Daleth7/QIF-model/Images/2015-12-08 13.44.57.jpg

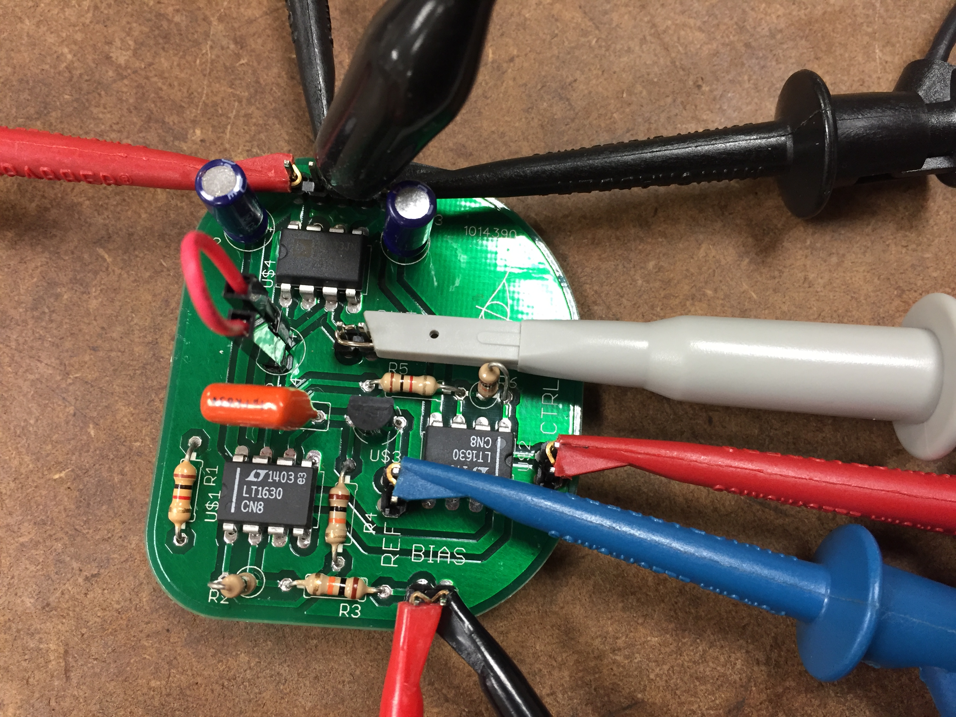
Images/2015-12-08 13.44.57.jpg
