Daleth7/QIF-model/Images/2015-12-08 13.44.27.jpg

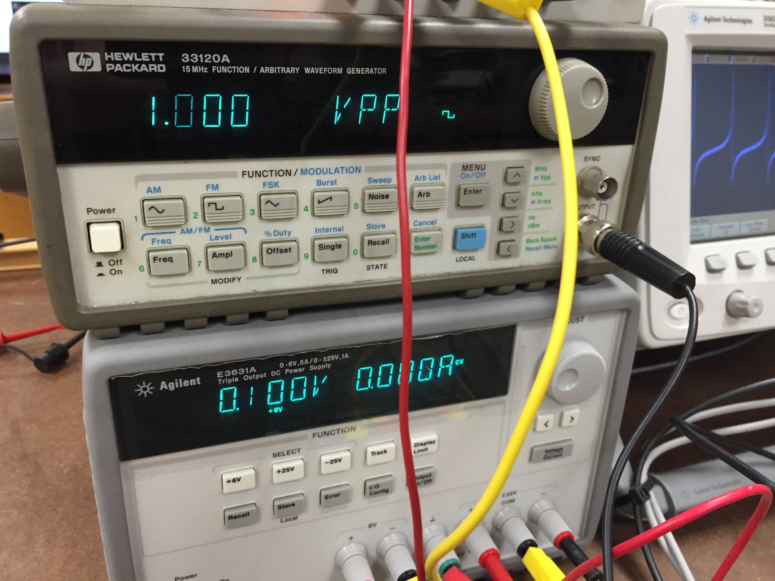
Images/2015-12-08 13.44.27.jpg
