Daleth7/QIF-model/Images/2015-12-08 13.45.04.jpg

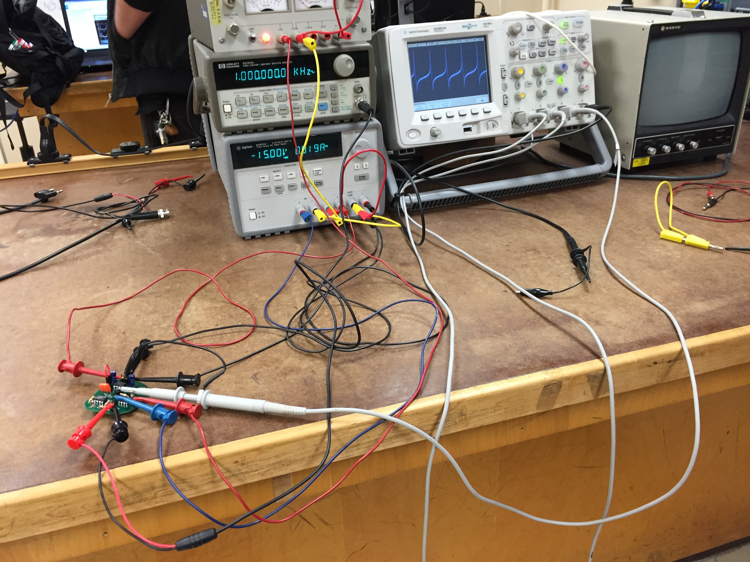
Images/2015-12-08 13.45.04.jpg
