Daleth7/QIF-model/Images/2015-12-08 13.54.20.jpg

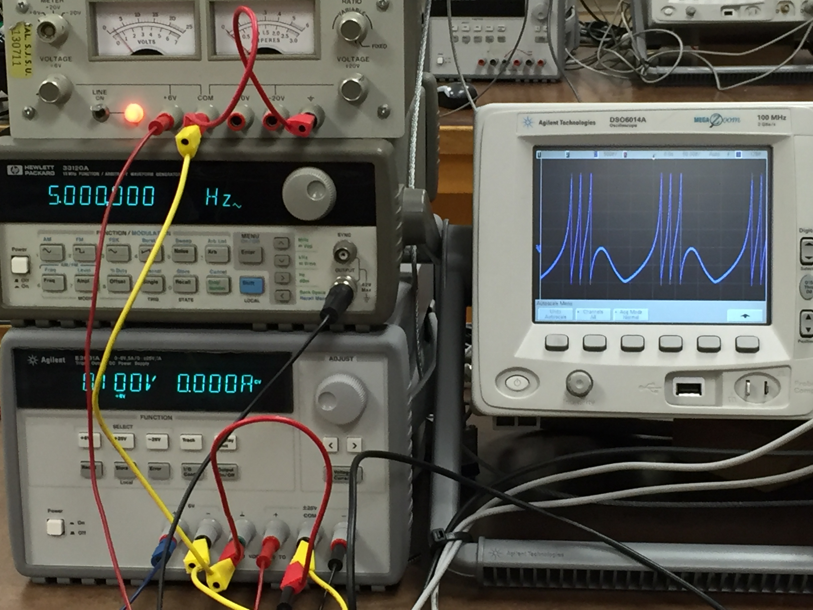
Images/2015-12-08 13.54.20.jpg
