Daleth7/QIF-model/QIF_Final.asc

C1: cap; 10µ
C2: cap; 1µ
M1: nmos; 2N7002
R2: res; 10k
R3: res; 1k
R4: res; 10k
R5: res; 10k
R6: res; 10k
R7: res; 1k
U1: LT1630
U2: LT1630
U4: LT1630
V1: voltage; 15
V2: voltage; -15
V3: voltage; PULSE(-1 1 0.1 0.5 0.5 0 1.2)
V4: voltage; 0.1
V5: voltage; 0.5
X1: ad633
Named nets: 0, +, -, Bias, OUT, V_sq, ref, ctrl
.tran 1.5 startup
