Daleth7/QIF-model/QIF.brd

## EAGLE design QIF.brd (2016-01-04)

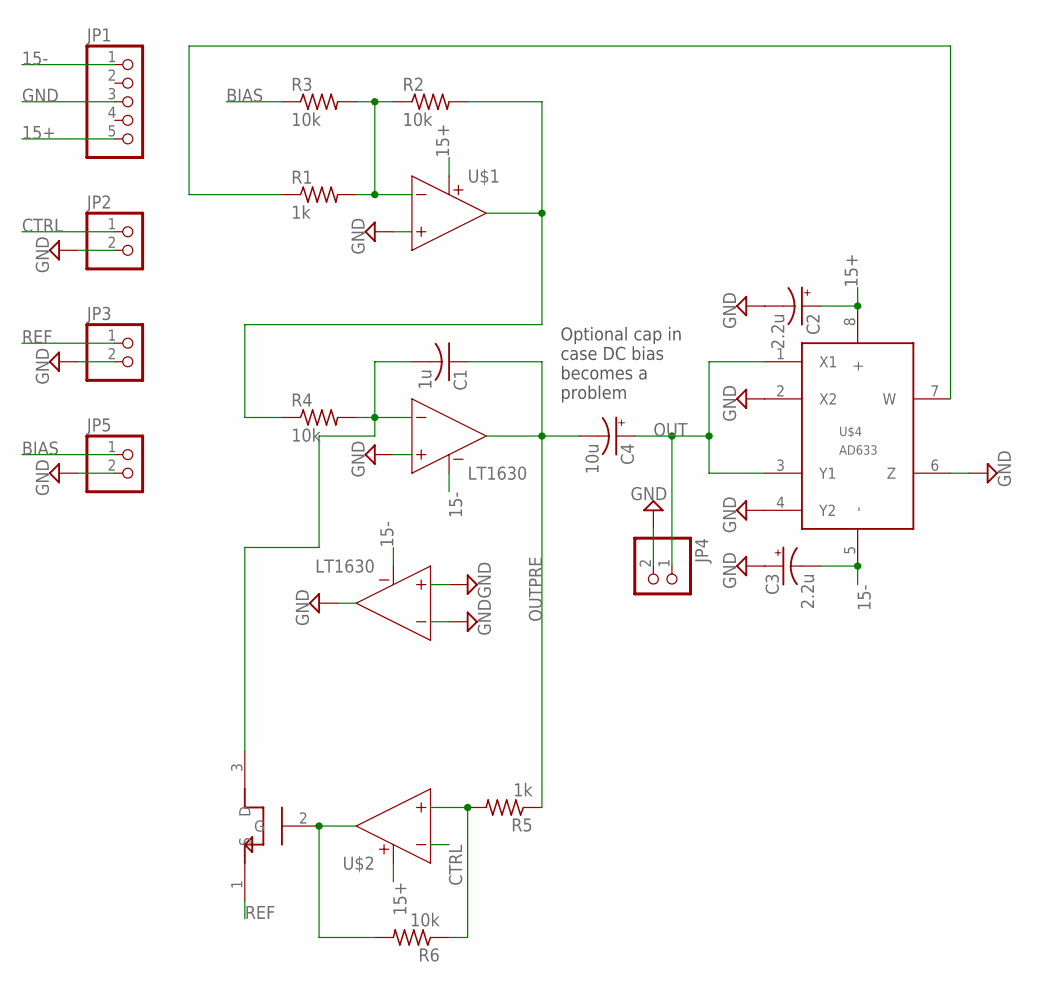
[picture p22: schematic QIF.sch]

Parts:
C1: 1u; C050-030X075
C2, C3: 2.2u; E2,5-6E
C4: 10u; E2,5-6
JP1: PINHD-1X5; 1X05
JP2, JP3, JP4, JP5: PINHD-1X2; 1X02
R1, R5: 1k; 0207/10
R2, R6: 10k; 0309V
R3, R4: 10k; 0207/10
U$1, U$2: LT1630; DIL8
U$3: 2N7000; TO-92
U$4: AD633; DIL8

Connections:
15+: C2.+, JP1.5, U$1.8 (V+), U$2.8 (V+), U$4.8 (+)
15-: C3.-, JP1.1, U$1.4 (V-), U$2.4 (V-), U$4.5 (-)
BIAS: JP5.1, R3.1
CTRL: JP2.1, U$2.2 (IN-)
GND: C2.-, C3.+, JP1.3, JP2.2, JP3.2, JP4.2, JP5.2, U$1.3 (IN+), U$1.5 (IN+1), U$2.5 (IN+1), U$2.6 (IN-1), U$2.7 (OUT1), U$4.2 (X2), U$4.4 (Y2), U$4.6 (Z)
unnamed: C1.2, R4.2, U$1.6 (IN-1), U$3.3 (D)
unnamed: R1.2, R2.1, R3.2, U$1.2 (IN-)
unnamed: R5.2, R6.1, U$2.3 (IN+)
unnamed: R2.2, R4.1, U$1.1 (OUT)
unnamed: R6.2, U$2.1 (OUT), U$3.2 (G)
unnamed: R1.1, U$4.7 (W)
OUT: C4.+, JP4.1, U$4.1 (X1), U$4.3 (Y1)
OUTPRE: C1.1, C4.-, R5.1, U$1.7 (OUT1)
REF: JP3.1, U$3.1 (S)

Notes on the sheet:
Optional cap in case DC bias becomes a problem

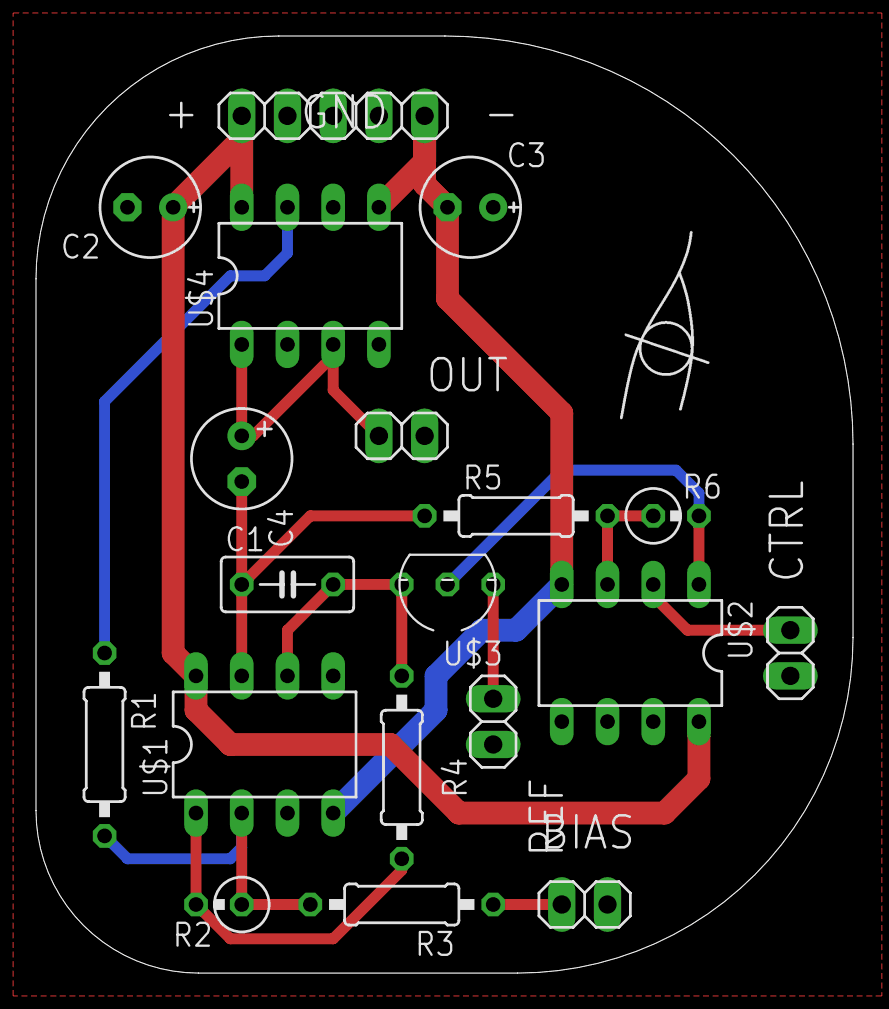
[picture p23: board QIF.brd from above]

Board: 2 copper layers, 45.4 x 52.1 mm, 20 parts (0 on the bottom side), 14 nets.

Other parts of the board:
U$5: LOGO
