Daleth7/QIF-model/(commit log)

2015-12-26 Initial commit -- Report and schematic only
2016-01-04 Added images and eagleCAD files
    [QIF.brd, QIF.sch]
